kylecorry31/compass-belt/(commit log)

2020-03-08 Rename to compass belt
2020-03-08 Fix orientation and add always on mode
    [Compass.cpp, Compass.h, CompassBelt.cpp, CompassBelt.h, HapticBelt.cpp, compass_belt.ino]
2020-03-09 Fix reference to declination
    [Compass.cpp]
2020-03-10 Make double pressing button toggle between the modes to avoid accidental updates
    [compass_belt.ino]
2020-03-11 Update calibration
2020-03-11 Add vibration interval for when you are not moving
    [CompassBelt.cpp, CompassBelt.h, compass_belt.ino]
2021-09-18 Support vibration strength setting
    [CompassBelt.cpp, HapticBelt.cpp, HapticBelt.h, compass_belt.ino]
2021-09-19 Add calibration support
